MehmettCelik/24S-Battery-to-12V-Buck-Converter-with-Isolated-Feedback/Hardware/3D/Bottom Side.png

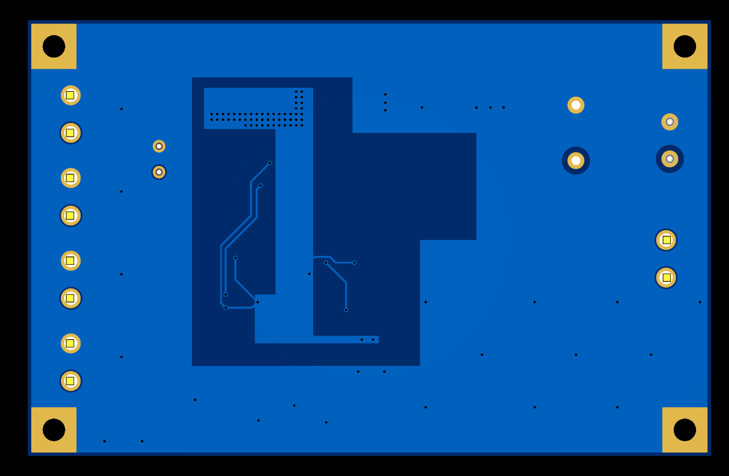
Hardware/3D/Bottom Side.png
