MehmettCelik/24S-Battery-to-12V-Buck-Converter-with-Isolated-Feedback/Hardware/3D/Top Side.png

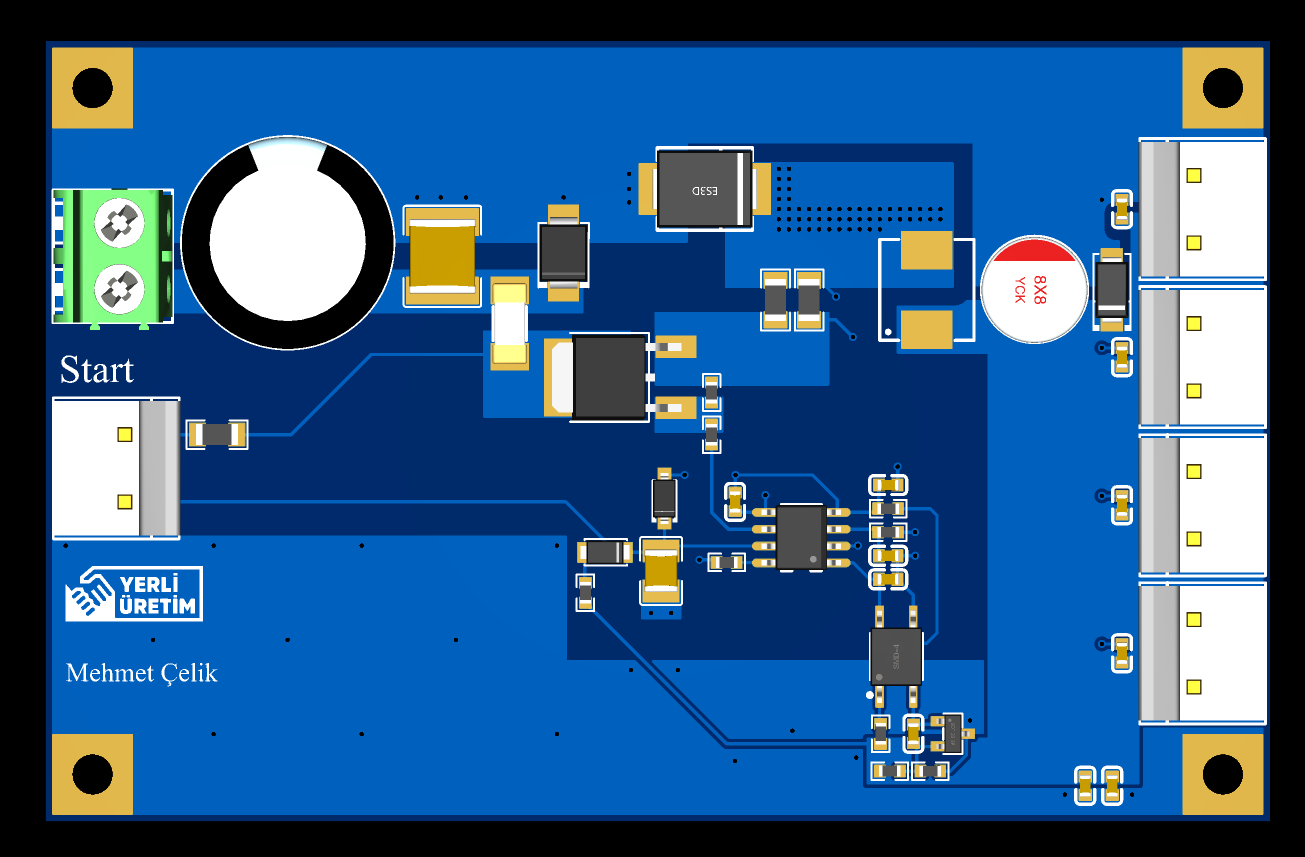
Hardware/3D/Top Side.png
