MehmettCelik/24S-Battery-to-12V-Buck-Converter-with-Isolated-Feedback/Hardware/Schematic.pdf

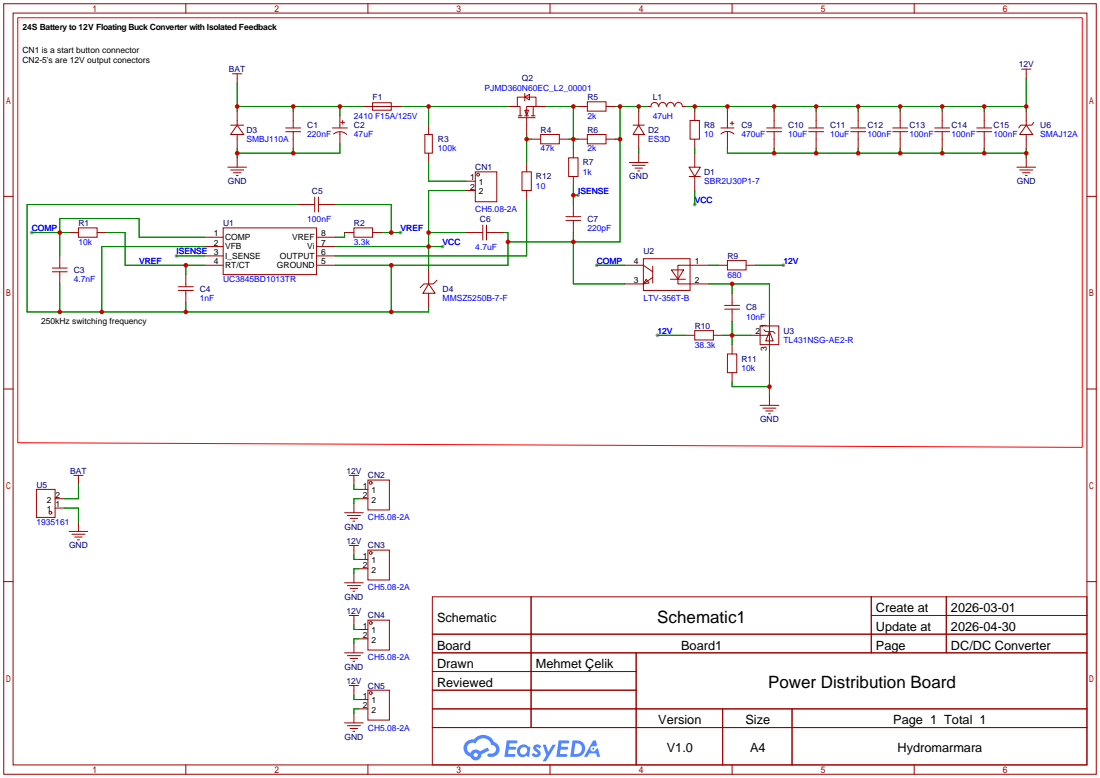
[picture p3: page 1]

24S Battery to 12V Floating Buck Converter with Isolated Feedback

CN1 is a start button connector
CN2-5's are 12V output conectors

Schematic | Schematic1 | Create at | 2026-03-01

Update at | 2026-04-30

Board | Board1 | Page | DC/DC Converter
Drawn | Mehmet Çelik | Power Distribution Board
Reviewed

Version | Size | Page 1 Total 1
V1.0 | A4 | Hydromarmara
