MehmettCelik/24S-Battery-to-12V-Buck-Converter-with-Isolated-Feedback/Hardware/PCB_Layout.pdf

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

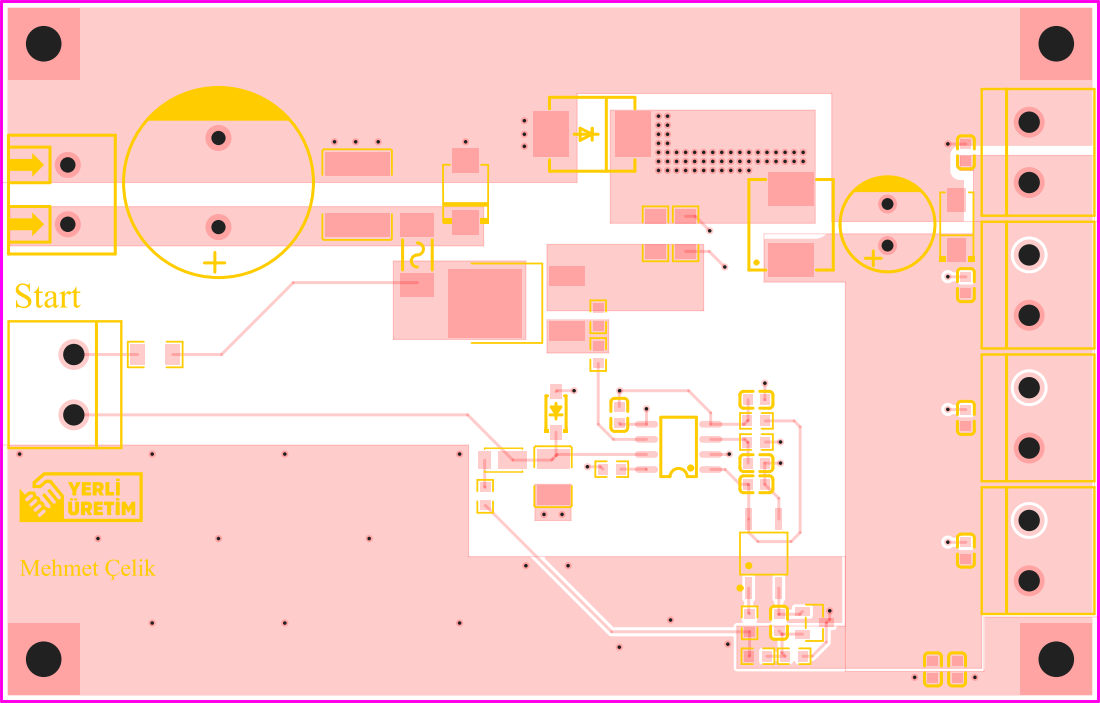
[picture p4: page 1]

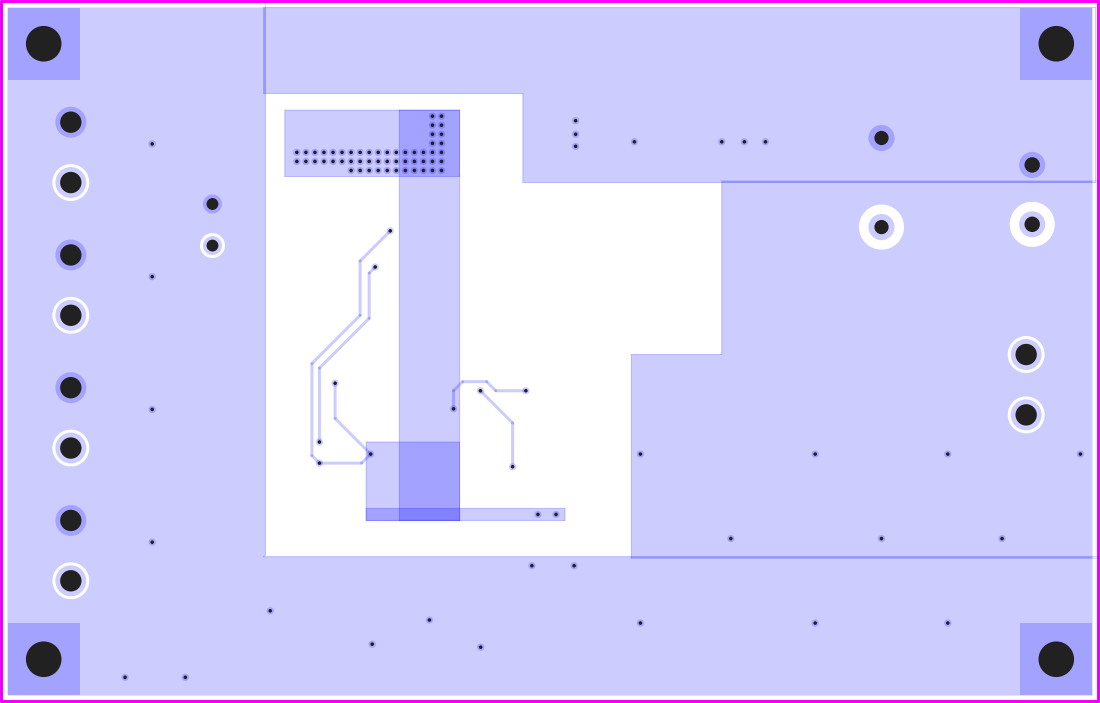
[picture p5: page 2]

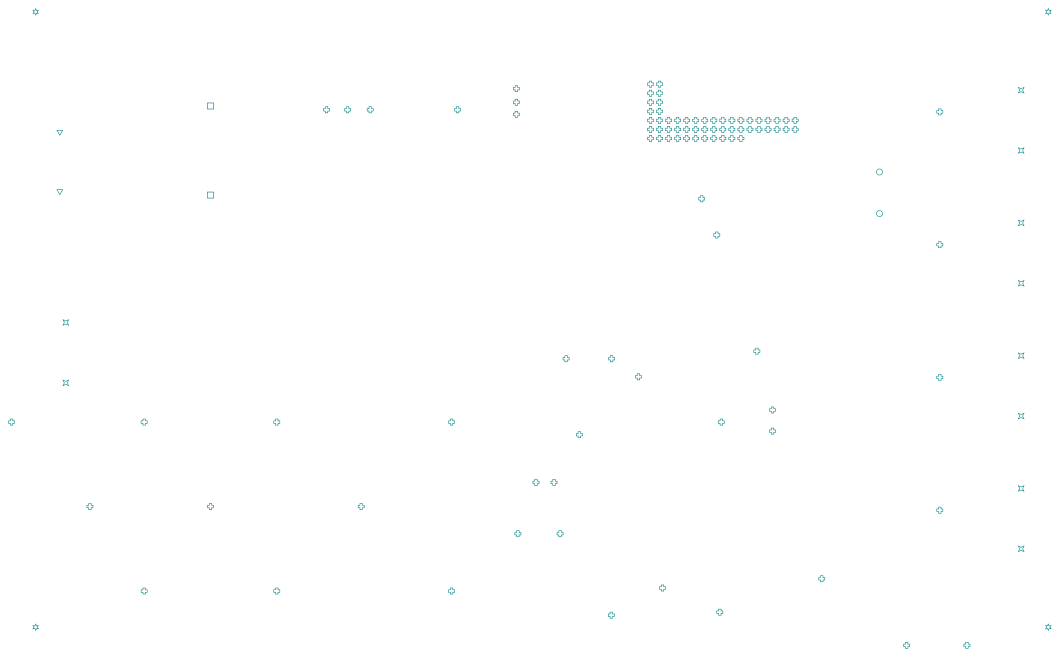
[picture p6: page 3]
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
