MehmettCelik/24S-Battery-to-12V-Buck-Converter-with-Isolated-Feedback/Simulation/DC-DC_Converter.asc

C1: cap; 4.7µ; V=25 Irms=0 Rser=0.004 Lser=0 mfg="TDK" pn="C4532X7RIE475M" type="X7R"
C2: cap; 0.001µ; V=50 Irms=0 Rser=0 Lser=0 mfg="Murata" pn="GRM1885C1H102JA01" type="C0G"
C3: cap; 470µ; V=25 Irms=470m Rser=0.16 Lser=0 mfg="Nichicon" pn="UPR1E471MPH" type="Al electrolytic"
C4: cap; 0.0047µ; V=25 Irms=0 Rser=0.0889 Lser=266p mfg="Würth Elektronik" pn="885012009004 WCAP-CSGP 1210" type="NP0"
C5: cap; 220p; V=50 Irms=0 Rser=0.4833 Lser=274p mfg="Würth Elektronik" pn="885012207082 WCAP-CSGP 0805" type="X7R"
C6: cap; 0.1µ; V=25 Irms=0 Rser=0.0189 Lser=443p mfg="Würth Elektronik" pn="885012206071R WCAP-CSGP 0603" type="X7R"
C7: cap; 10µ; V=25 Irms=0 Rser=0.0035 Lser=644p mfg="Würth Elektronik" pn="885012108021 WCAP-CSGP 1206" type="X5R"
C8: cap; 0.01µ; V=50 Irms=0 Rser=0.0379 Lser=363p mfg="Würth Elektronik" pn="885012010013 WCAP-CSGP 1812" type="NP0"
C9: cap; 0.22µ; V=630 Irms=0 Rser=0.0165 Lser=1000p mfg="Würth Elektronik" pn="885342214142 WCAP-CSMH 2220" type="X7R"
C10: cap; 10µ; V=25 Irms=0 Rser=0.0035 Lser=644p mfg="Würth Elektronik" pn="885012108021 WCAP-CSGP 1206" type="X5R"
C11: cap; 47µ; V=400 Irms=300m Rser=0.6027 Lser=14.439n mfg="Würth Elektronik" pn="860021380015 WCAP-ATG5 16x25" type="Al electrolytic"
C12: cap; 10µ; V=25 Irms=0 Rser=0.0035 Lser=644p mfg="Würth Elektronik" pn="885012108021 WCAP-CSGP 1206" type="X5R"
D1: diode; RF501BGE2S
D2: diode; RFN5BM3S
I1: current; PULSE(0 0.5 100m 10n 10n 25m 50m)
L1: ind; 47µ; Ipk=4.2 Rser=0.11 Rpar=55395.2 Cpar=0 mfg="Bourns, Inc." pn="SRR1806-470M"
M2: nmos; STP8NM60
R1: res; 10
R2: res; 47k
R3: res; 100k
R4: res; 3.3k
R5: res; 9
R6: res; 10
R7: res; 38.3k
R8: res; 10k
R9: res; 250m; tol=1 pwr=5
R10: res; 1k
R11: res; 10k
R12: res; 680
U1: LT1245
U2: PC817D
U3: TL431
V1: voltage; 72
Named nets: 0, VCC
.tran 300m startup
.include TL431.mod
.ic V(VCC)=0
